LGerlinger/RAZA/capture assemblage.png

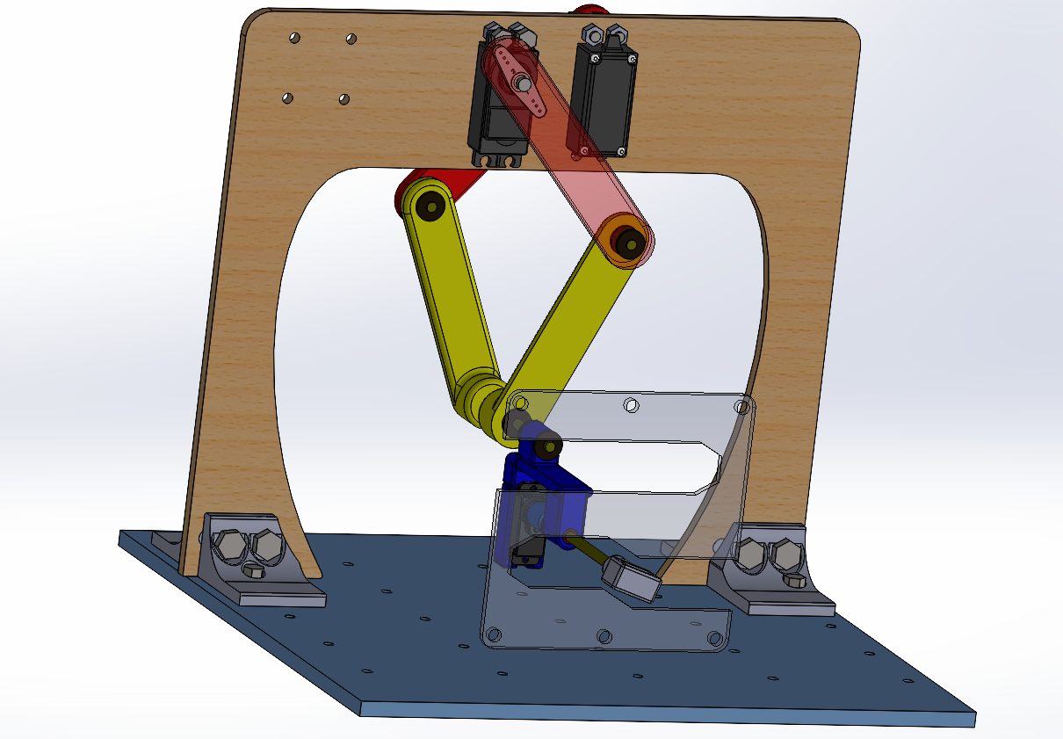
capture assemblage.png
