LGerlinger/RAZA/(commit log)

2022-05-11 Delete Pièces et assemblages.zip
    Une nouvelle et probablement définitive version doit la remplacer.
    On change l'arche et la façon dont est fait l'assemblage principal.
2022-05-11 Nouvelle version de Pièces et assemblages
